LurLab-UCI/Behavior_GUIs/github images/full_rig.JPG

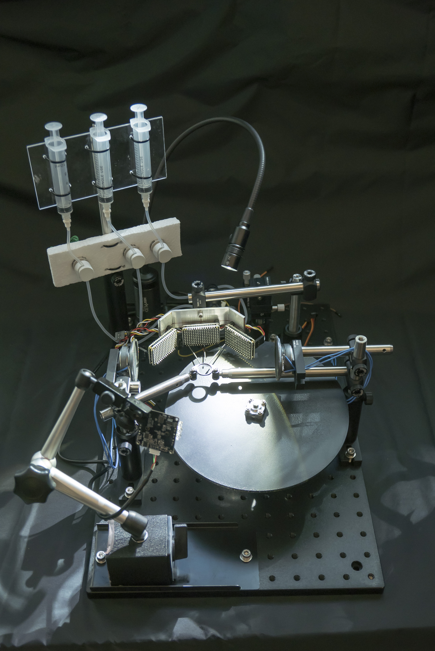
github images/full_rig.JPG
