LurLab-UCI/Behavior_GUIs/github images/mouse_view.JPG

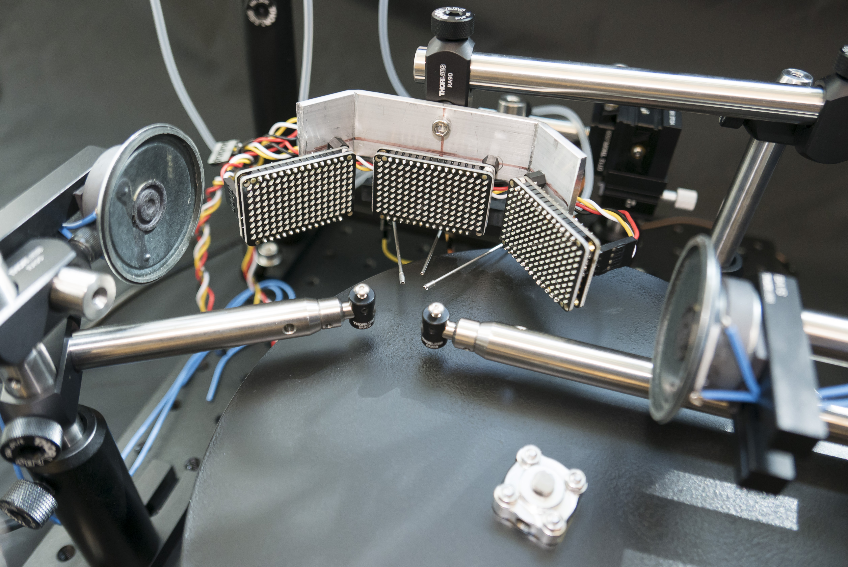
github images/mouse_view.JPG
