LurLab-UCI/Behavior_GUIs/README.md

# Behavior_GUIs
This is a comprehensive, affordable and highly flexible hardware-software solution for head-fixed behaviors

For installation instructions and documentation see Wiki
