LurLab-UCI/Behavior_GUIs/github images/2AFC_boards.jpg

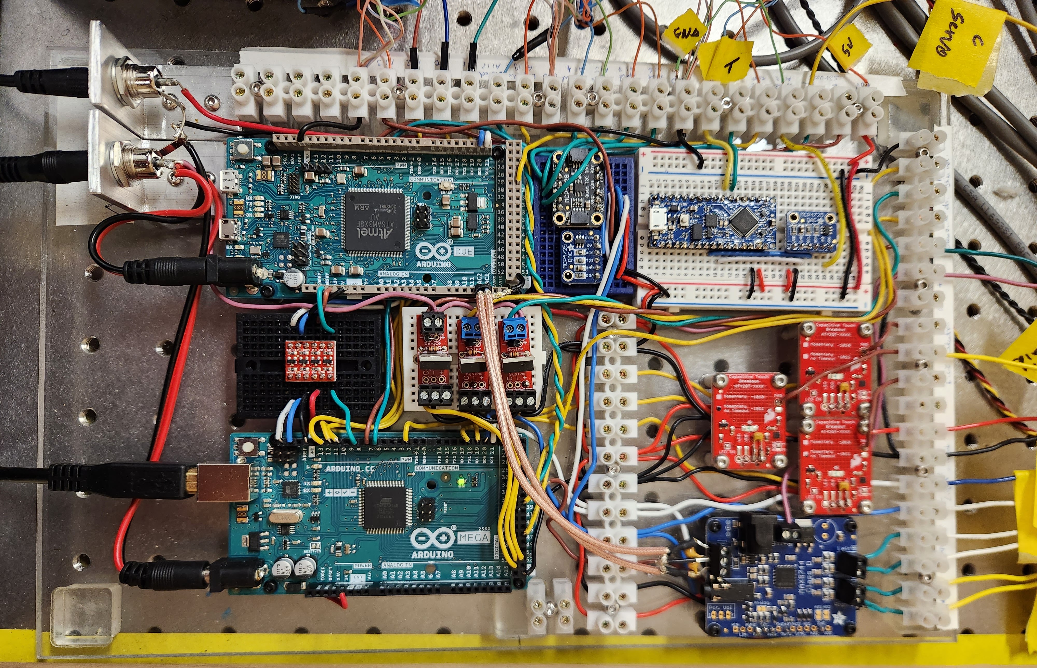
github images/2AFC_boards.jpg
