LurLab-UCI/Behavior_GUIs/github images/2AFC_GUI.jpg

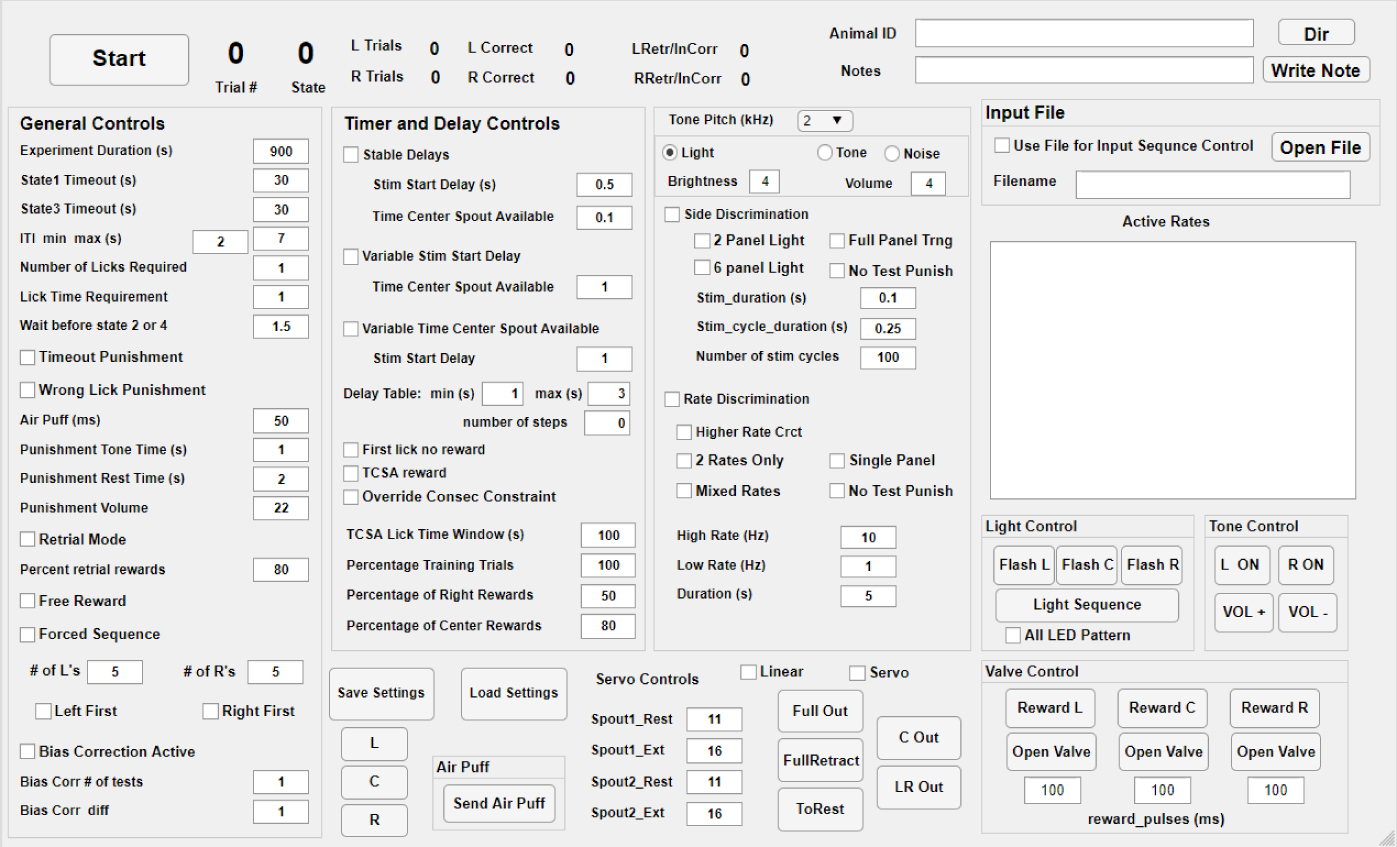
github images/2AFC_GUI.jpg
