LurLab-UCI/Behavior_GUIs/github images/enclosure.jpg

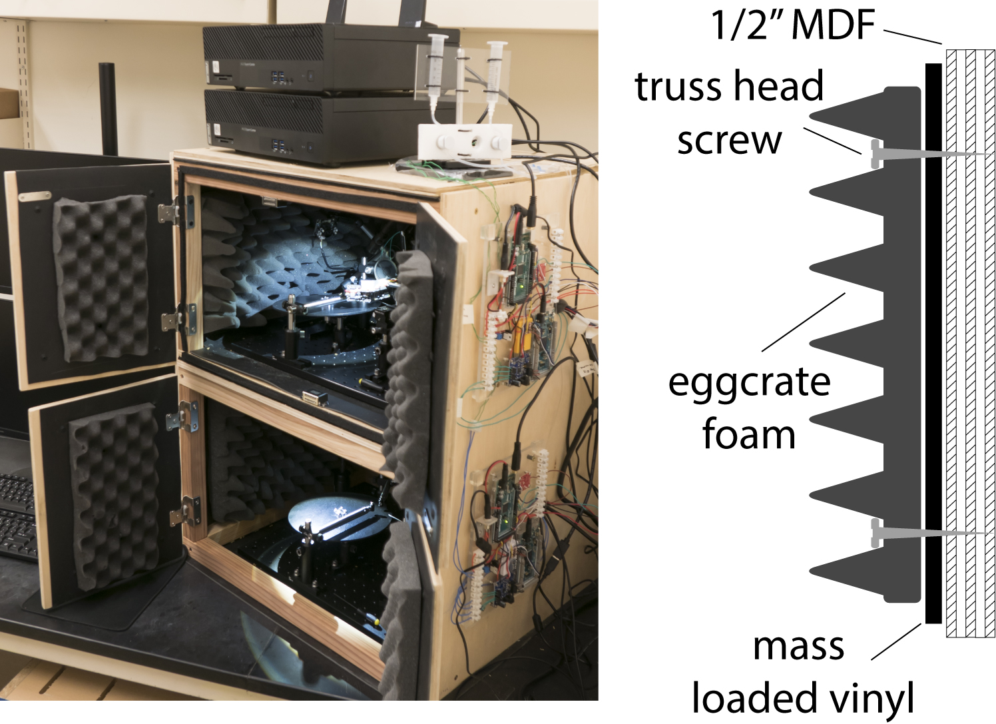
github images/enclosure.jpg
