LurLab-UCI/Behavior_GUIs/github images/Figure 2 - circuit diagram.png

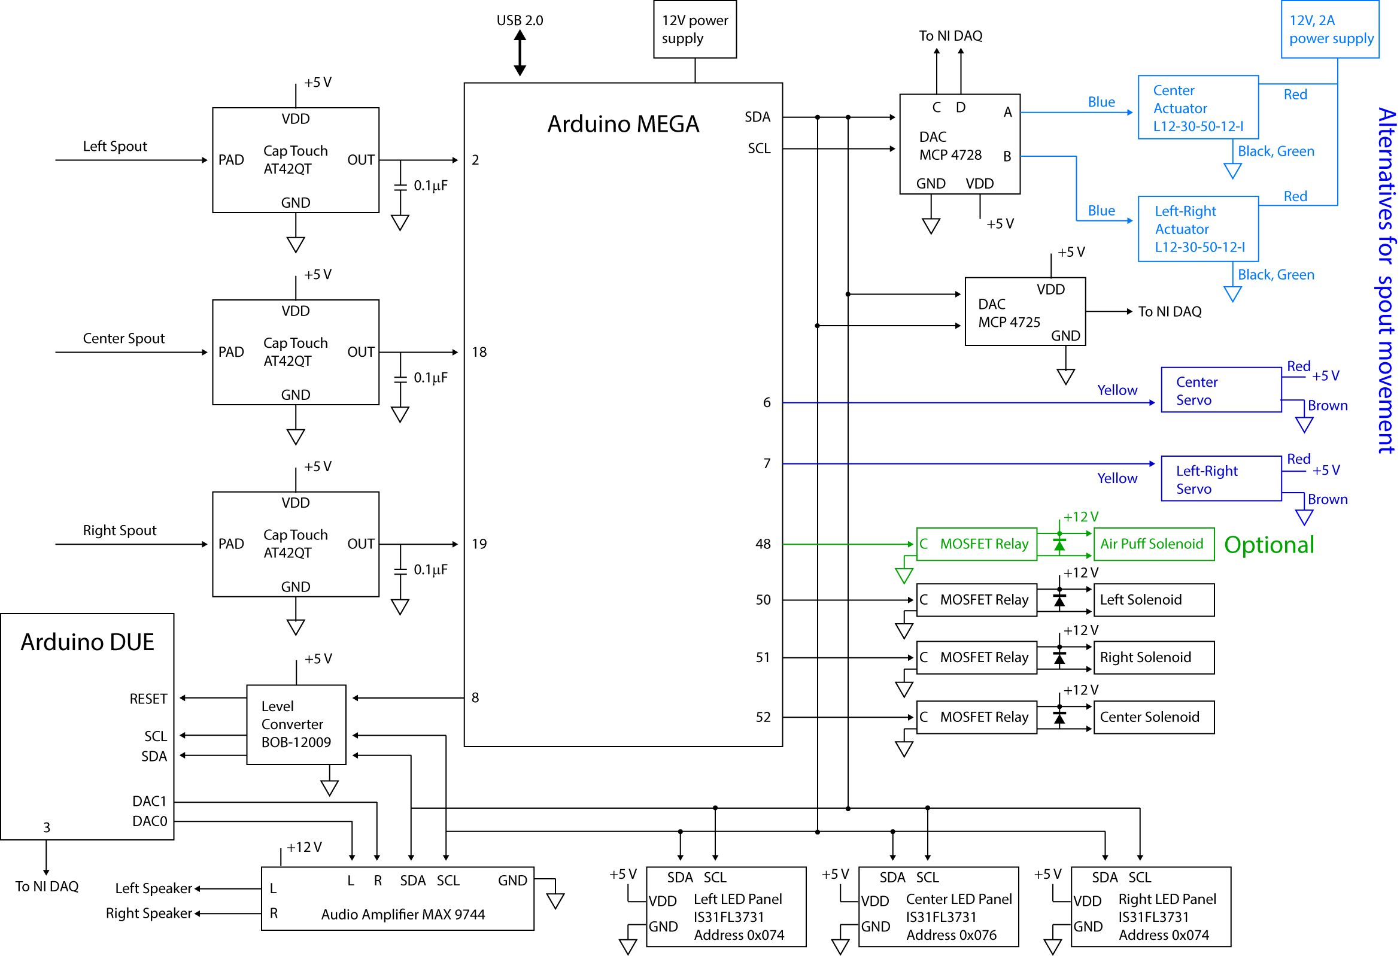
github images/Figure 2 - circuit diagram.png
