LurLab-UCI/Behavior_GUIs/github images/GNG_boards.jpg

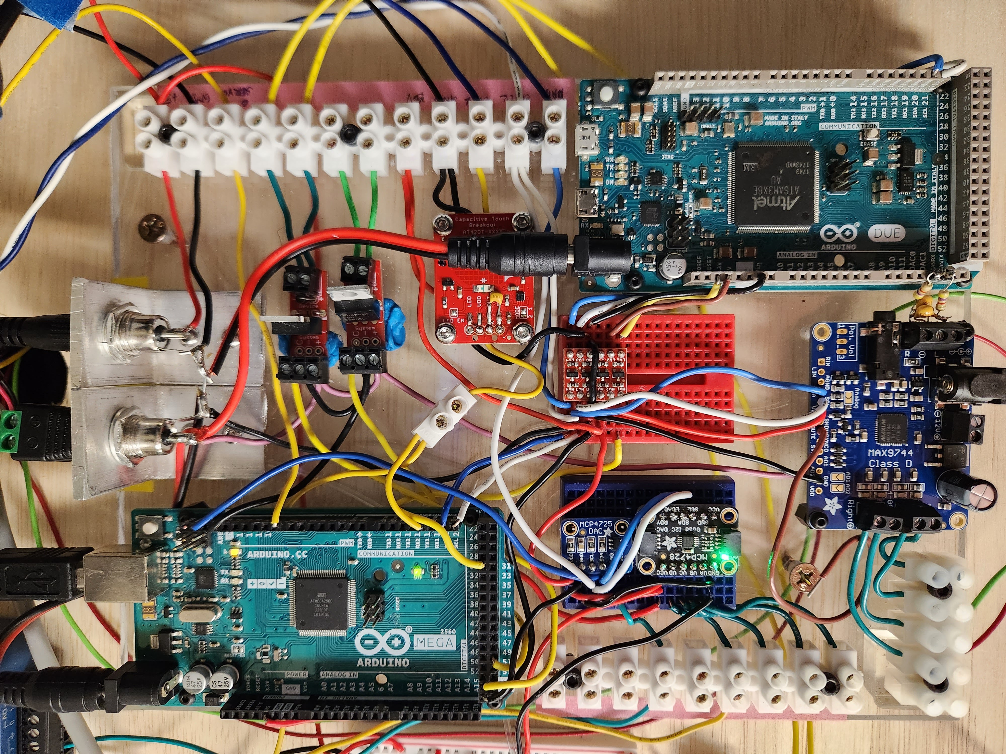
github images/GNG_boards.jpg
