LurLab-UCI/Behavior_GUIs/github images/GNG_GUI.jpg

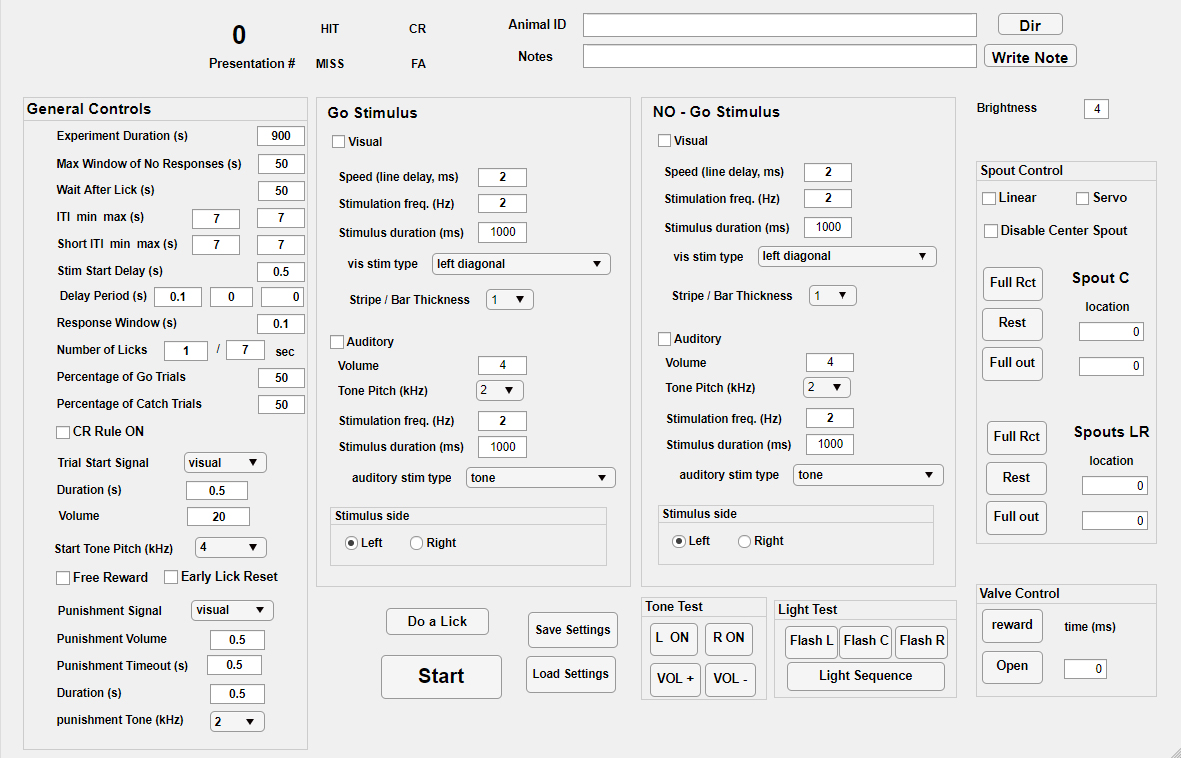
github images/GNG_GUI.jpg
