LurLab-UCI/Behavior_GUIs/github images/lick_spouts.JPG

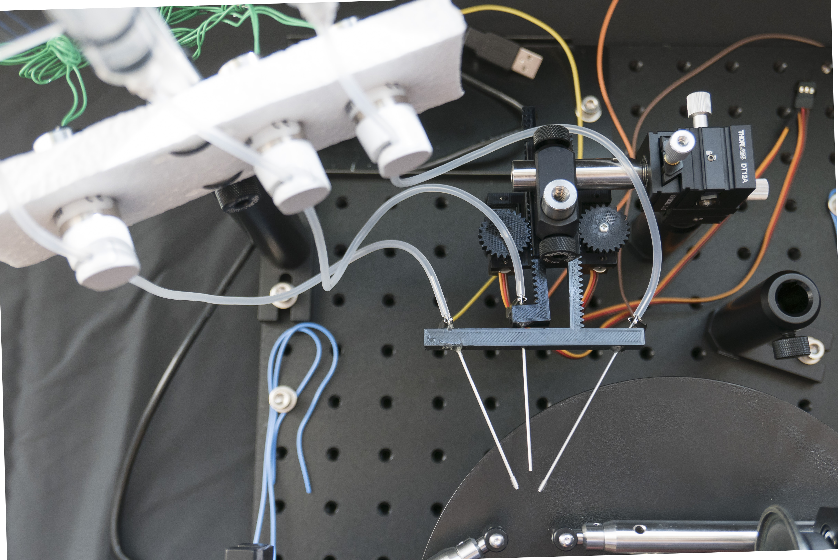
github images/lick_spouts.JPG
