LurLab-UCI/Behavior_GUIs/github images/mouse_view2.JPG

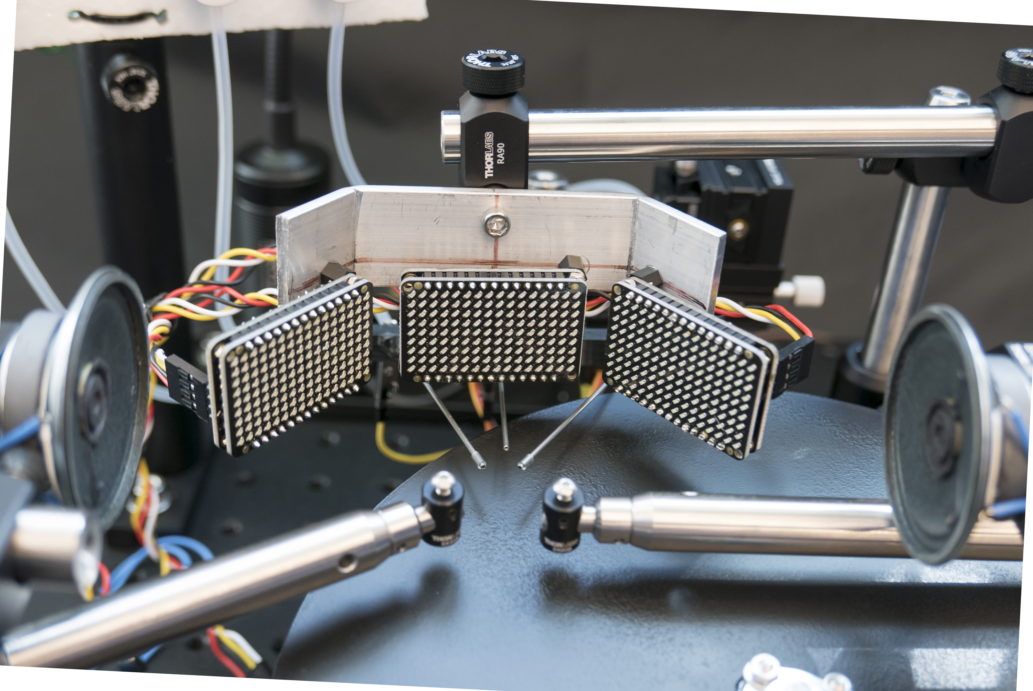
github images/mouse_view2.JPG
