LurLab-UCI/Behavior_GUIs/github images/SFig 1 - detailed 2AFC state machine.png

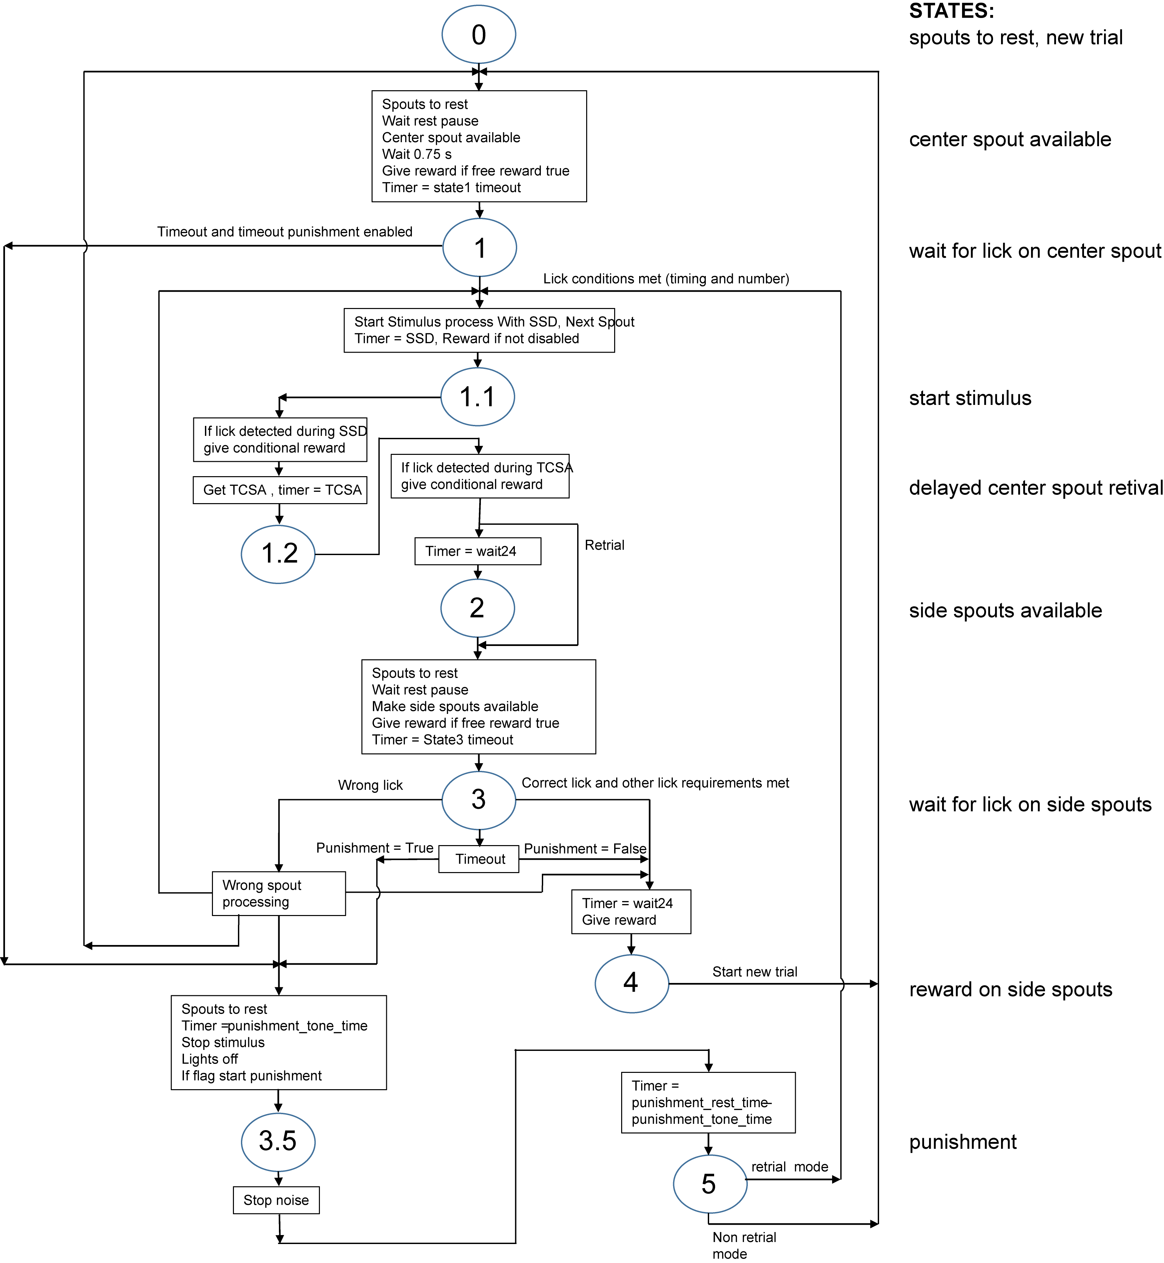
github images/SFig 1 - detailed 2AFC state machine.png
