LurLab-UCI/Behavior_GUIs/github images/SFig 2 - detailed Go-NoGo state machine.png

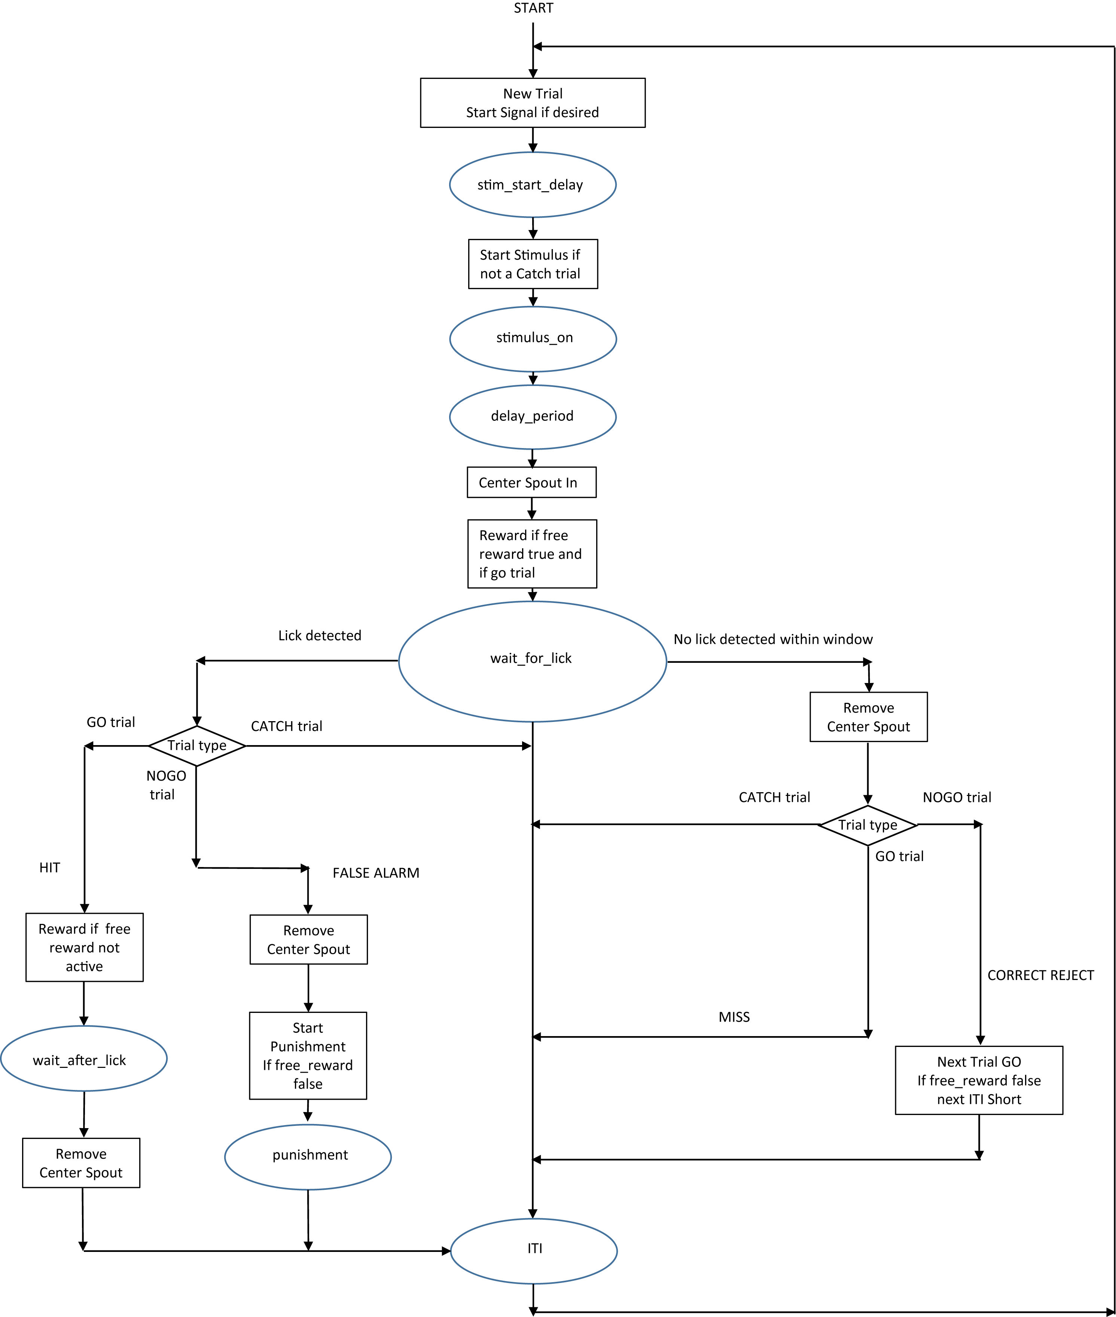
github images/SFig 2 - detailed Go-NoGo state machine.png
