LurLab-UCI/Behavior_GUIs/github images/SS_GUI.jpg

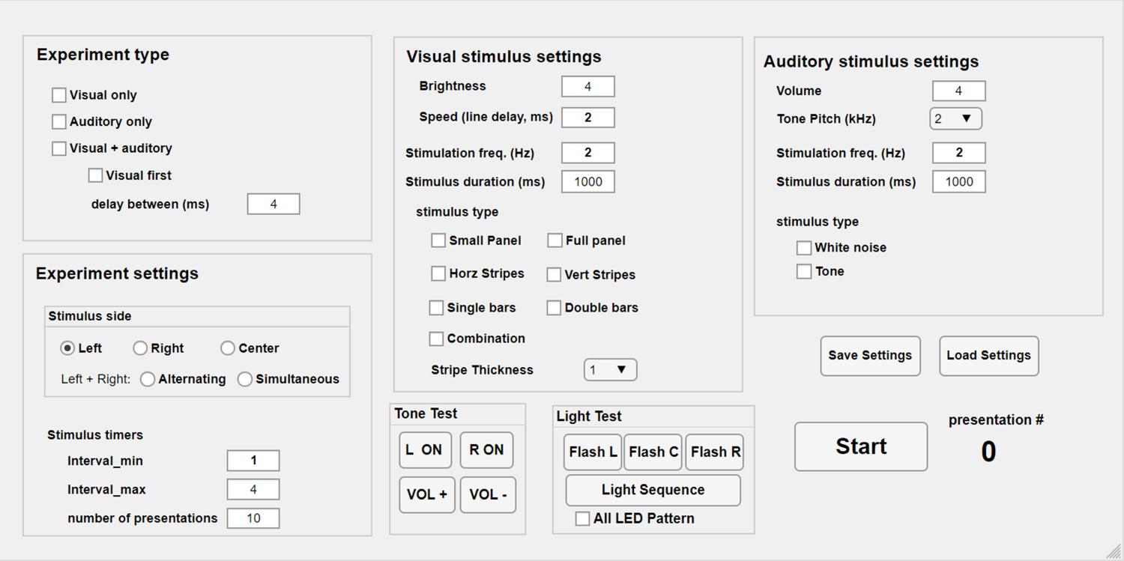
github images/SS_GUI.jpg
