LurLab-UCI/Behavior_GUIs/3D files/spout-holder-for-linear-actuator.STL

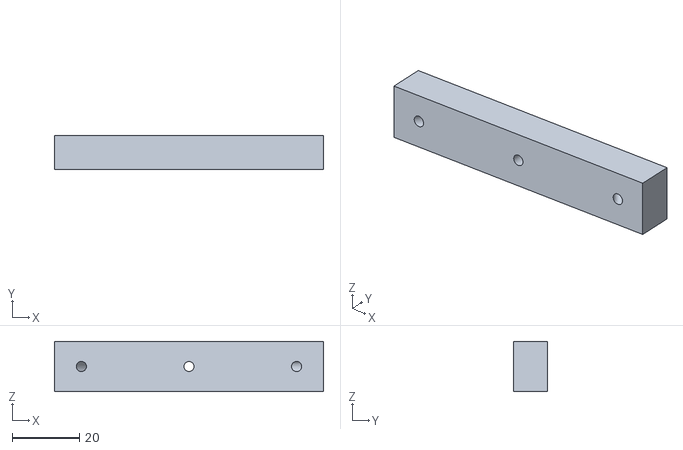
[picture p14: CAD file, 2023-01-11]
3D files/spout-holder-for-linear-actuator.STL
80.0 x 10.00 x 15.0
