LurLab-UCI/Behavior_GUIs/3D files/LED-panel-holder.STL

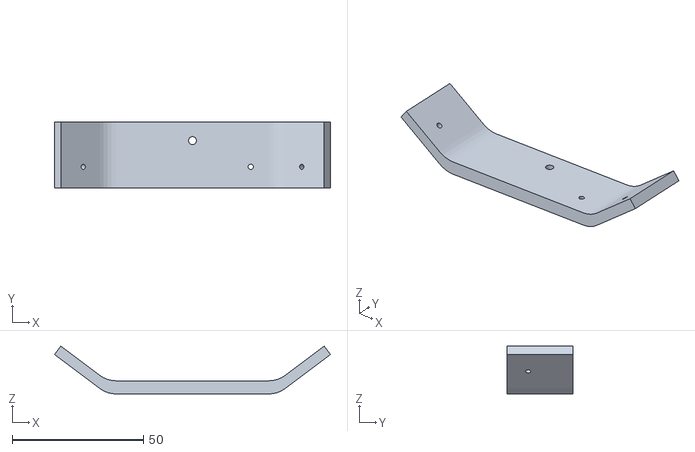
[picture p15: CAD file, 2023-01-11]
3D files/LED-panel-holder.STL
105.0 x 25.0 x 18.2
