LurLab-UCI/Behavior_GUIs/3D files/servo-to-linear-actuator-translator.stl

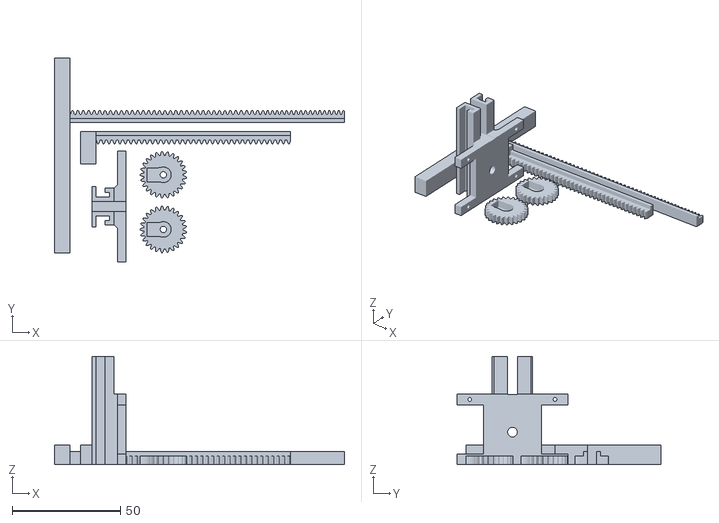
[picture p16: CAD file, 2023-01-11]
3D files/servo-to-linear-actuator-translator.stl
133.8 x 94.3 x 50.0
